sasha-rana/belt-mount-sim/build/stl/antisub-spreader.stl

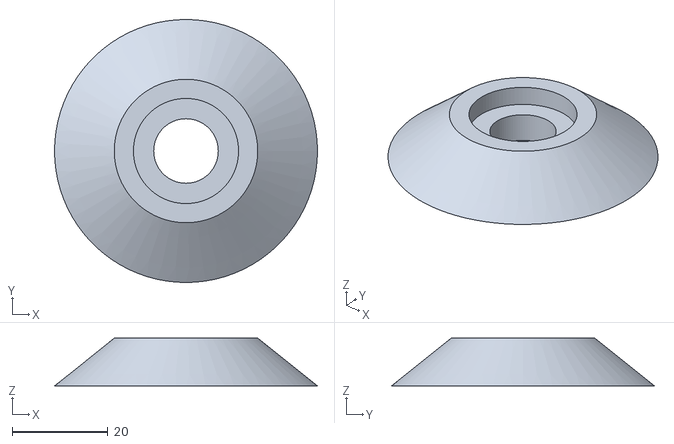
[picture p1: CAD file, 2026-10-22]
build/stl/antisub-spreader.stl
55.0 x 55.0 x 10.0
