sasha-rana/belt-mount-sim/build/stl/lap-bushing.stl

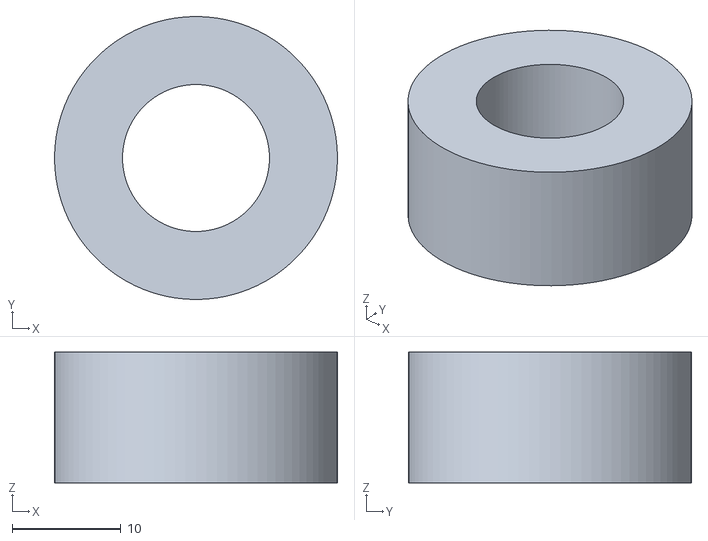
[picture p2: CAD file, 2026-10-22]
build/stl/lap-bushing.stl
26.0 x 26.0 x 12.0
