sasha-rana/belt-mount-sim/build/stl/inner-skin.stl

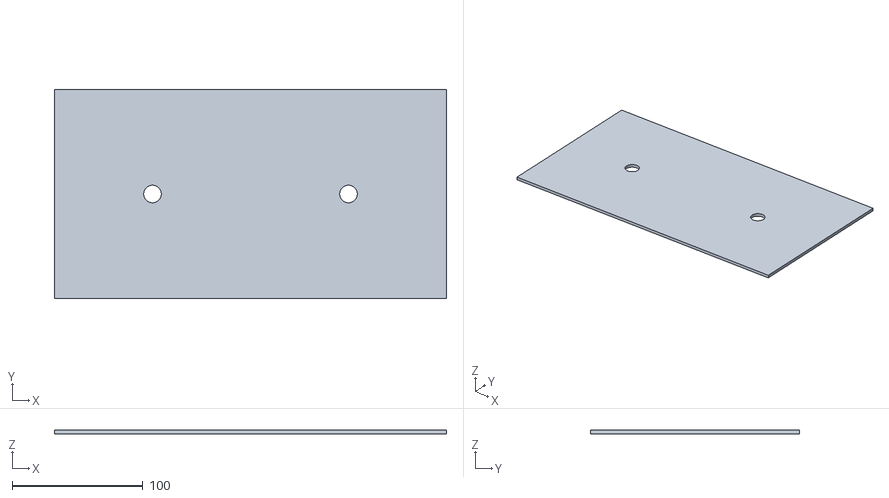
[picture p3: CAD file, 2026-10-22]
build/stl/inner-skin.stl
300.0 x 160.0 x 2.84
