sasha-rana/belt-mount-sim/build/stl/lap-annulus.stl

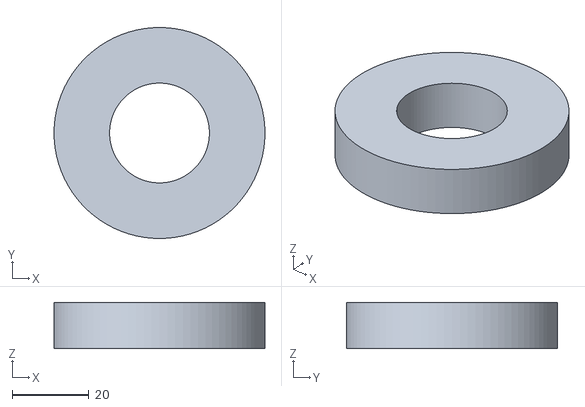
[picture p4: CAD file, 2026-10-22]
build/stl/lap-annulus.stl
55.0 x 55.0 x 12.0
