sasha-rana/belt-mount-sim/build/stl/core.stl

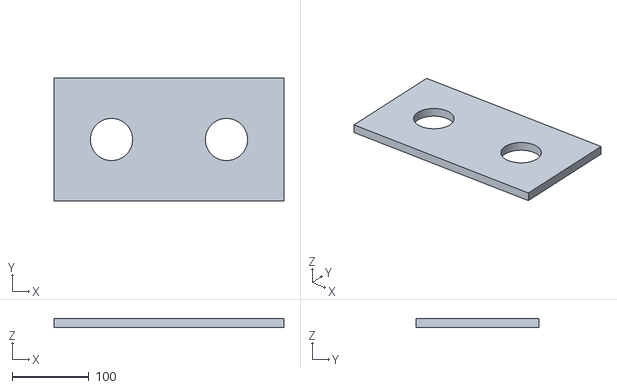
[picture p5: CAD file, 2026-10-22]
build/stl/core.stl
300.0 x 160.0 x 12.0
