sasha-rana/belt-mount-sim/build/stl/lap-backing.stl

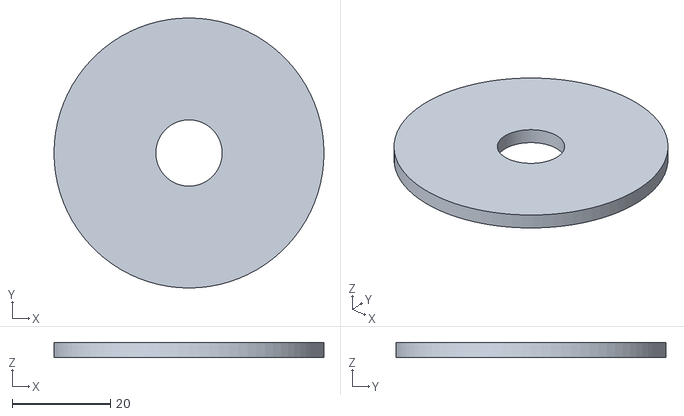
[picture p6: CAD file, 2026-10-22]
build/stl/lap-backing.stl
55.0 x 55.0 x 3.00
