sasha-rana/belt-mount-sim/build/stl/antisub-eyebolt.stl

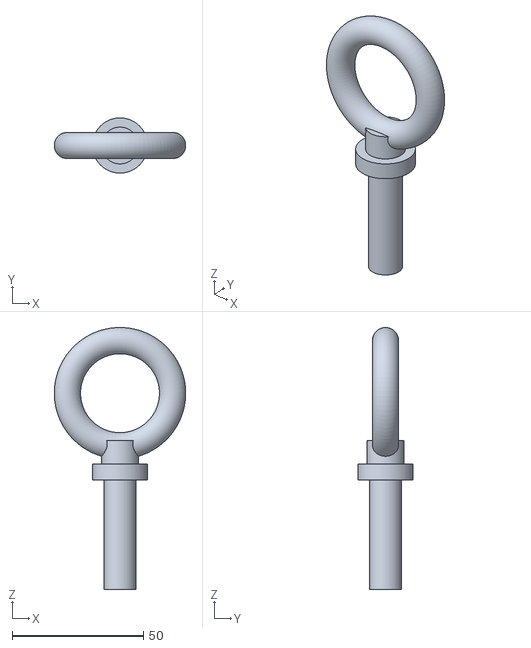
[picture p7: CAD file, 2026-10-22]
build/stl/antisub-eyebolt.stl
50.0 x 21.0 x 99.7
