sasha-rana/belt-mount-sim/build/stl/lap-nut.stl

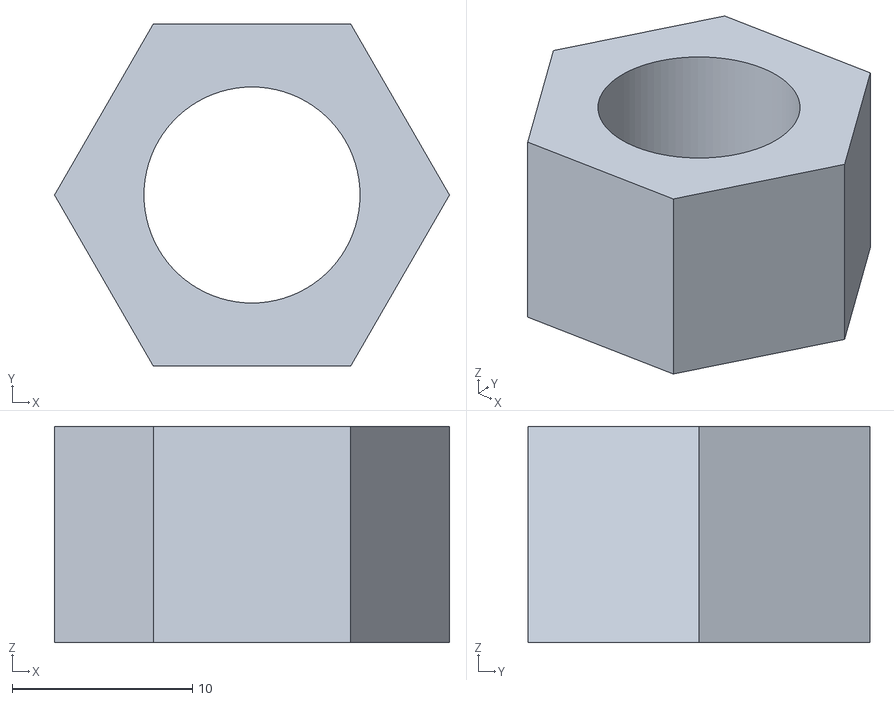
[picture p8: CAD file, 2026-10-22]
build/stl/lap-nut.stl
21.9 x 19.0 x 12.0
