sasha-rana/belt-mount-sim/(list of files, cad)

Other CAD files:
build/stl/antisub-bushing.stl
build/stl/outer-skin.stl
build/stl/antisub-annulus.stl
build/stl/antisub-backing.stl
build/stl/lap-spreader.stl
build/stl/lap-eyebolt.stl
build/stl/antisub-nut.stl
