sasha-rana/belt-mount-sim/(commit log)

2026-10-22 Add belt-mount 3D viewer with assembly and statics data
    TypeScript + three.js viewer (viewer/) for the lap / anti-sub belt mount:
    orbit/pan/zoom, part selection with mass info, explode, section cut,
    safety-factor colouring, and MuJoCo force vectors with free-body diagrams
    across a 0-100% belt-load ramp.
    Data (build/): FreeCAD STL export, part masses, pull-test results and the
    per-step interface forces the viewer reads.
    [antisub-annulus.stl, antisub-backing.stl, antisub-bushing.stl, antisub-eyebolt.stl, antisub-nut.stl, antisub-spreader.stl, core.stl, inner-skin.stl]
2026-10-22 Add FreeCAD and MuJoCo scripts that generate the viewer data
    freecad/: parametric mount model (mount_model.py) and the builder that
    exports STLs and part masses (build_mount.py, run with freecadcmd).
    mujoco/: MJCF builder, quasi-static pull test, stress post-processing,
    counterbore study, force export for the viewer, and the MuJoCo viewer.
    Generated files (belt_mount.xml, BeltMount.FCStd) are ignored.
2026-10-22 Viewer: URL deep links, solid force arrows, cut-face view
    - URL parameters set the load case, colouring, explode, section, selected
    part, load step and camera (e.g. ?case=belt30&color=sf), for sharing
    views and scripted screenshots; ui=0 hides the sidebar.
    - Force arrows are solid shaft-and-cone meshes instead of 1 px lines, and
    the overview callout columns are spaced so labels don't overlap.
    - "Cut face" view looks at the section plane; removed the stray axes marker.
